ConnorHoang/STM-scale/controller-board/Core/Src/main.c

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
/* Includes ------------------------------------------------------------------*/
#include "main.h"

/* USER CODE BEGIN Includes */
#include <stdio.h>
#include <stdint.h>
#include <string.h>
#include <math.h>
/* USER CODE END Includes */

/* USER CODE BEGIN PD */
#define VK16K33_ADDR (0x70 << 1)

#define SCALE_COUNT      2
#define SPI_FRAME_SIZE   10	
#define SPI_FRAME_SYNC   0xA5

// 0 while the display is unplugged: with no I2C pull-ups the bus reads busy
// and every display write spins long enough to starve the main loop
#define DISPLAY_CONNECTED 0
/* USER CODE END PD */

I2C_HandleTypeDef hi2c1;

SPI_HandleTypeDef hspi1;

TIM_HandleTypeDef htim2;
TIM_HandleTypeDef htim3;

UART_HandleTypeDef huart2;

/* USER CODE BEGIN PV */
static const uint8_t g_number_table[] = {
    0x3F, /* 0 */
	0x06, /* 1 */
	0x5B, /* 2 */
	0x4F, /* 3 */
    0x66, /* 4 */
	0x6D, /* 5 */
	0x7D, /* 6 */
	0x07, /* 7 */
    0x7F, /* 8 */
	0x6F, /* 9 */
	0x77, /* a */
	0x7C, /* b */
    0x39, /* C */
	0x5E, /* d */
	0x79, /* E */
	0x71  /* F */
};

volatile uint8_t id_display_requested = 0; // Flag set by EXTI
volatile uint8_t display_update_due = 0;   // Flag set by TIM3

static uint8_t i2c_tx[11];
uint8_t ID_showing;

// latest reading from each sensor board, written by SPI_Read_Scale()
typedef struct {
	int16_t  mass;			// tared, calibrated weight
	uint16_t adc_raw;		// raw adc average
	uint16_t tare;			// raw adc value at last tare
	uint8_t  seq;			// slave sample counter
	uint8_t  flags;			// bit 0: tare applied
	uint8_t  valid;			// last read passed sync + checksum
} scale_reading_t;

scale_reading_t scales[SCALE_COUNT];

static const struct {
	GPIO_TypeDef *port;
	uint16_t pin;
} scale_cs[SCALE_COUNT] = {
	{ SPI1_CS_A_GPIO_Port, SPI1_CS_A_Pin },
	{ SPI1_CS_B_GPIO_Port, SPI1_CS_B_Pin },
};

volatile uint8_t active_scale = 0;		// state of the board shown [0 = a, 1 = b]
volatile uint8_t poll_due = 0;			// set by TIM2 at 100 Hz
volatile uint8_t streams = 0;
/* USER CODE END PV */

void SystemClock_Config(void);
static void MX_GPIO_Init(void);
static void MX_I2C1_Init(void);
static void MX_SPI1_Init(void);
static void MX_TIM2_Init(void);
static void MX_TIM3_Init(void);
static void MX_USART2_UART_Init(void);
/* USER CODE BEGIN PFP */
void Display_Value(float sensor_grams);
void Display_Show_Scale_ID(uint8_t scale_num);
void SPI_Read_Scale(uint8_t idx);
void UART_Send_Scale(uint8_t idx);
/* USER CODE END PFP */

/**
  * @brief  The application entry point.
  * @retval int
  */
int main(void)
{

  /* MCU Configuration--------------------------------------------------------*/

  /* Reset of all peripherals, Initializes the Flash interface and the Systick. */
  HAL_Init();

  /* Configure the system clock */
  SystemClock_Config();

  /* Initialize all configured peripherals */
  MX_GPIO_Init();
  MX_I2C1_Init();
  MX_SPI1_Init();
  MX_TIM2_Init();
  MX_TIM3_Init();
  MX_USART2_UART_Init();
  /* USER CODE BEGIN 2 */
  uint8_t osc_cmd = 0x21;
  if (HAL_I2C_Master_Transmit(&hi2c1, VK16K33_ADDR, &osc_cmd, 1, 100) != HAL_OK) {
        Error_Handler();
    }

    // Turn on display
    uint8_t display_cmd = 0x81;
    HAL_I2C_Master_Transmit(&hi2c1, VK16K33_ADDR, &display_cmd, 1, 100);

    // Set brightness to medium (0xEF for max, 0xE7 for mid)
    uint8_t bright_cmd = 0xE7;
    HAL_I2C_Master_Transmit(&hi2c1, VK16K33_ADDR, &bright_cmd, 1, 100);

  // Timer
  HAL_TIM_Base_Start_IT(&htim2);
  HAL_TIM_Base_Start_IT(&htim3);
//
//  // 4. Test pattern: Show '8' on all 4 digits and turn colon on
//  //    Register address: 0x00
//  //    0x7F = binary 01111111 (all segments A-G active)
//  uint8_t test_frame[11] = {
//      0x00,       // Start at register 0x00
//      0x7F, 0x00, // Digit 0: '8'
//      0x7F, 0x00, // Digit 1: '8'
//      0x02, 0x00, // Colon: ON (bit 1)
//      0x7F, 0x00, // Digit 2: '8'
//      0x7F, 0x00  // Digit 3: '8'
//  };
//  HAL_I2C_Master_Transmit(&hi2c1, VK16K33_ADDR, test_frame, sizeof(test_frame), 100);

  /* USER CODE END 2 */

  /* Infinite loop */
  /* USER CODE BEGIN WHILE */
    while (1)
    {
    /* USER CODE END WHILE */

    /* USER CODE BEGIN 3 */
	if (poll_due) {
		poll_due = 0;
		for (uint8_t i = 0; i < SCALE_COUNT; i++) {
			SPI_Read_Scale(i);
            UART_Send_Scale(i);
		}
		}
	if (id_display_requested) {
			id_display_requested = 0;
			Display_Show_Scale_ID(active_scale);
		}

	if (display_update_due) {
		display_update_due = 0;
		// Safe to display val
		if (streams & (1u << active_scale)) {
			Display_Value(scales[active_scale].mass);
		} else {
			if (HAL_I2C_GetState(&hi2c1) == HAL_I2C_STATE_READY){
				memset(i2c_tx, 0, 11);
				HAL_I2C_Master_Transmit_IT(&hi2c1, VK16K33_ADDR, i2c_tx, 11);
			}
		}
	}
    __WFI();
  }
  /* USER CODE END 3 */
}

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
/* USER CODE BEGIN 4 */
void Display_Show_Scale_ID(uint8_t scale_num) {
    if (HAL_I2C_GetState(&hi2c1) != HAL_I2C_STATE_READY) return;
//    HAL_TIM_Base_Stop_IT(&htim3);
    ID_showing = 0;


    i2c_tx[0] = 0x00;
    i2c_tx[1] = 0x6D; i2c_tx[2] = 0x00; // 'S'
    i2c_tx[3] = 0x39; i2c_tx[4] = 0x00; // 'C'
    i2c_tx[5] = 0x02; i2c_tx[6] = 0x00; // Colon ON
    i2c_tx[7] = g_number_table[(scale_num / 10) % 10]; i2c_tx[8] = 0x00;
    i2c_tx[9] = g_number_table[scale_num % 10];        i2c_tx[10] = 0x00;

    HAL_I2C_Master_Transmit_IT(&hi2c1, VK16K33_ADDR, i2c_tx, 11);
//    HAL_TIM_Base_Start_IT(&htim3);

}

void Display_Value(float sensor_grams) {
    // Abort if I2C is still busy sending the last message
	ID_showing = ID_showing + 1;

    if ((HAL_I2C_GetState(&hi2c1) != HAL_I2C_STATE_READY) || ID_showing < 5 || streams == 0) return;

    ID_showing = 60;
    int display_val = (int)(sensor_grams * 10.0f);

    if (display_val < 0) display_val = 0;
    if (display_val > 9999) display_val = 9999;

    uint8_t d0 = (display_val / 1000) % 10;
    uint8_t d1 = (display_val / 100)  % 10;
    uint8_t d2 = (display_val / 10)   % 10;
    uint8_t d3 = display_val % 10;

    i2c_tx[0] = 0x00;
    i2c_tx[1] = g_number_table[d0]; i2c_tx[2] = 0x00;
    i2c_tx[3] = g_number_table[d1]; i2c_tx[4] = 0x00;
    i2c_tx[5] = 0x00;               i2c_tx[6] = 0x00; // Colon OFF
    i2c_tx[7] = g_number_table[d2] | 0x80; i2c_tx[8] = 0x00; // Decimal ON
    i2c_tx[9] = g_number_table[d3]; i2c_tx[10] = 0x00;

    HAL_I2C_Master_Transmit_IT(&hi2c1, VK16K33_ADDR, i2c_tx, 11);
}

void SPI_Read_Scale(uint8_t idx) {
	uint8_t tx[SPI_FRAME_SIZE] = {0};	// generate clock
	uint8_t rx[SPI_FRAME_SIZE];

	HAL_GPIO_WritePin(scale_cs[idx].port, scale_cs[idx].pin, GPIO_PIN_RESET);
	HAL_StatusTypeDef status = HAL_SPI_TransmitReceive(&hspi1, tx, rx, SPI_FRAME_SIZE, 5);
	HAL_GPIO_WritePin(scale_cs[idx].port, scale_cs[idx].pin, GPIO_PIN_SET);

	// run checksum to validaete packet
	uint8_t checksum = 0;
	for (uint8_t i = 0; i < SPI_FRAME_SIZE; i++) {
		checksum ^= rx[i];
	}

	// fallback if board is missing
	if (status != HAL_OK || rx[0] != SPI_FRAME_SYNC || checksum != 0) {
		scales[idx].valid = 0;
		return;
	}

	scales[idx].seq        = rx[1];
	scales[idx].mass       = (int16_t) ((rx[2] << 8) | rx[3]);
	scales[idx].adc_raw    = (rx[4] << 8) | rx[5];
	scales[idx].tare       = (rx[6] << 8) | rx[7];
	scales[idx].flags      = rx[8];
	scales[idx].valid      = 1;
}

void UART_Send_Scale(uint8_t idx)
{
	if (!(streams & (1u << idx))) return;   // switch off: don't send

	char buf[32];
	int n;
	char id = 'A' + idx;

	if (scales[idx].valid) {
		n = snprintf(buf, sizeof buf, "%c,%d,%d,%d,%d,%d\r\n",
		             id, scales[idx].seq, scales[idx].mass,
		             scales[idx].adc_raw, scales[idx].tare, scales[idx].flags);
	} else {
		n = snprintf(buf, sizeof buf, "%c,ERR\r\n", id);
	}

	HAL_UART_Transmit(&huart2, (uint8_t *)buf, n, 10);
}

void HAL_TIM_PeriodElapsedCallback(TIM_HandleTypeDef *htim)
{
	if (htim->Instance == TIM2) {
		poll_due = 1;
	}
	else if (htim->Instance == TIM3) {
		display_update_due = 1;
	}
}

void HAL_GPIO_EXTI_Callback(uint16_t GPIO_Pin)
{
	uint16_t led;
	uint8_t bit;

	if (GPIO_Pin == GPIO_PIN_2) {
		led = GPIO_PIN_6;
		bit = 0x01;

	} else if (GPIO_Pin == GPIO_PIN_3) {
		led = GPIO_PIN_7;
		bit = 0x02;
	} else return;

	if (HAL_GPIO_ReadPin(GPIOC, GPIO_Pin) == GPIO_PIN_RESET){
		streams |= bit;
		active_scale = bit >> 1;
		id_display_requested = 1;
	} else {
	    streams &= ~bit;
	    if (streams) {                       // other switch still on → show that board
	        active_scale = (streams & 0x01) ? 0 : 1;
	        id_display_requested = 1;
	    }
	}

	HAL_GPIO_WritePin(GPIOC, led, (streams & bit) ? GPIO_PIN_SET : GPIO_PIN_RESET);
}

/* USER CODE END 4 */
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
