ConnorHoang/STM-scale/controller-board/Core/Inc/main.h

#define SPI1_CS_A_Pin GPIO_PIN_4
#define SPI1_CS_A_GPIO_Port GPIOC
#define SPI1_CS_B_Pin GPIO_PIN_5
#define SPI1_CS_B_GPIO_Port GPIOC
