ConnorHoang/STM-scale/(commit log)

2026-10-28 Add initial I2C project files
2026-10-28 Upload timer adc + dma for sensing boards
2026-10-28 update to include timer
2026-10-29 integrated SPI frame protocol RX with existing ADC handler
2026-10-29 moved ADC files to new directory
2026-10-29 implemented SPI handeler and typedef
2026-10-29 update frame sync
2026-10-29 updated clock, added tim3, some uart, not all, use for testing spi
2026-10-30 removed test data and wired to actual ADC values
2026-10-31 added and confirmed switch and led functionality
2026-10-31 fix clock and add uart
    [I2C.ioc, main.c]
2026-11-01 version that fully works with hub+A from switch to uart
